PionixPublic/cb-eval-board/cb-eval-board/adcs.kicad_sch

## KiCad design cb-eval-board/adcs.kicad_sch (2025-07-17)

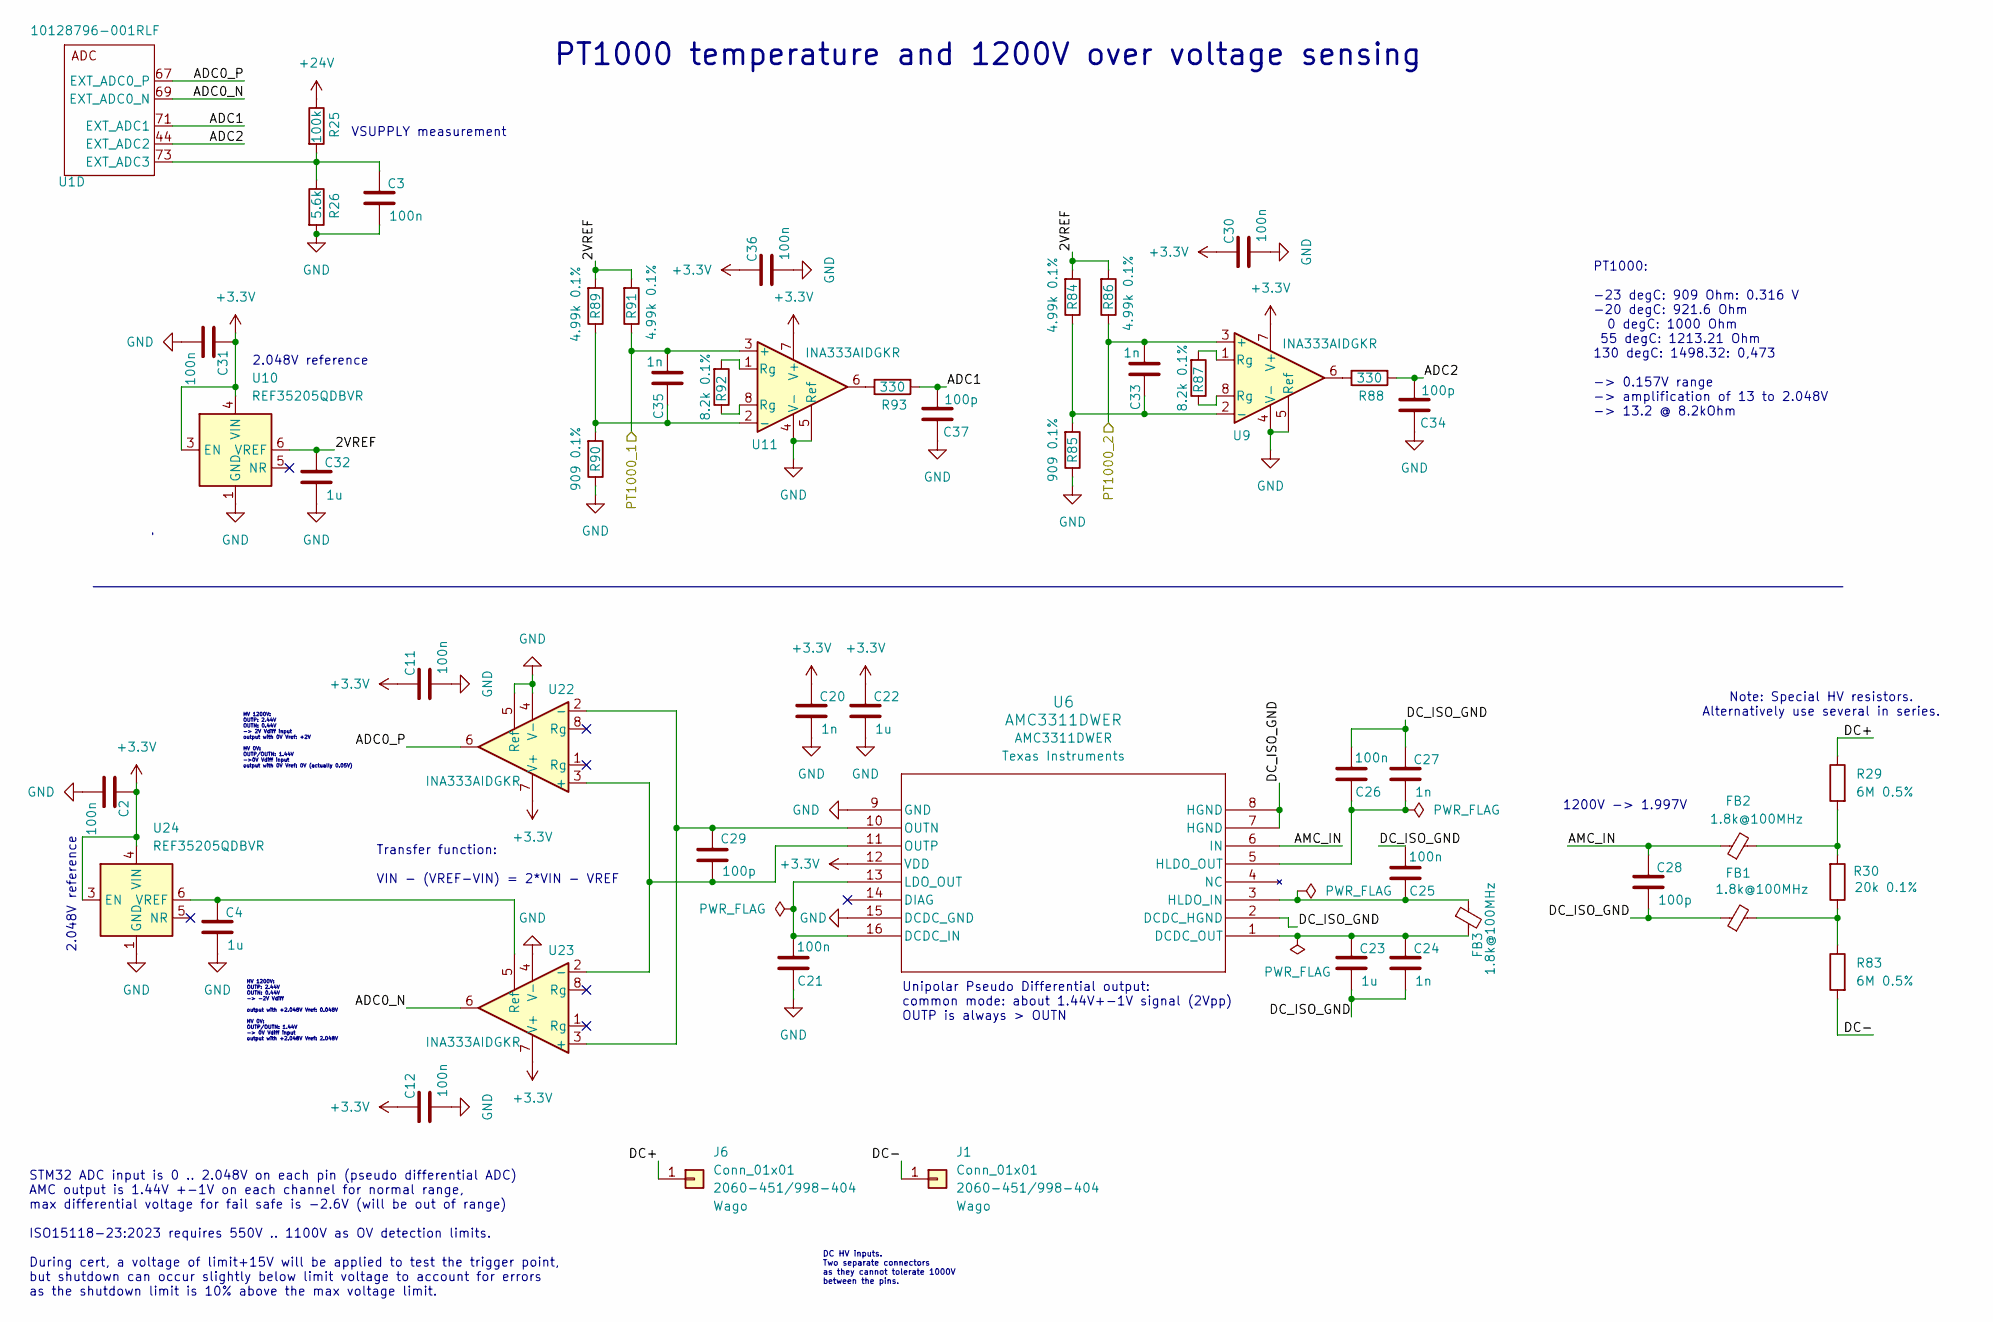
[picture p1: schematic adcs.kicad_sch]

Parts:
C2, C3, C11, C12, C21, C25, C26, C30, C31, C36: 100n; C_0603_1608Metric; MPN C0603C104K5RACAUTO; Digikey 399-6856-1-ND
C4, C22, C23, C32: 1u; C_0603_1608Metric; MPN C0603C105K3PACTU; Digikey 399-C0603C105K3PACTUCT-ND
C20, C24, C27, C33, C35: 1n; C_0603_1608Metric; MPN C0603C102K5RACTU; Digikey 399-C0603C102K5RACTUCT-ND
C28, C29, C34, C37: 100p; C_0603_1608Metric; MPN 0603N101J500CT; Digikey 1292-1644-1-ND
FB1, FB2, FB3: 1.8k@100MHz; L_0603_1608Metric; MPN 742792692; Digikey 732-4671-1-ND
J1, J6: Conn_01x01; 2060451998404; MPN 2060-451/998-404; Digikey 2946-2060-451/998-404CT-ND
R25: 100k; R_0603_1608Metric; MPN RMCF0603FT100K; Digikey RMCF0603FT100KCT-ND
R26: 5.6k; R_0603_1608Metric; MPN RMCF0603FT5K60; Digikey RMCF0603FT5K60CT-ND
R29, R83: 6M 0.5%; R_1206_3216Metric; MPN CRMA1206AF6M00DKEF; JLCPCB Part# C3986300
R30: 20k 0.1%; R_0603_1608Metric; MPN ERA-3AEB203V; JLCPCB Part# C469660
R84, R86, R89, R91: 4.99k 0.1%; R_0603_1608Metric; MPN ERA-3AEB4991V; Digikey P4.99KDBCT-ND
R85, R90: 909 0.1%; R_0603_1608Metric; MPN ERA-3AEB9090V; Digikey P909DBCT-ND
R87, R92: 8.2k 0.1%; R_0603_1608Metric; MPN ERA-3AEB822V; Digikey P8.2KDBCT-ND
R88, R93: 330; R_0603_1608Metric; MPN RMCF0603FT330R; Digikey RMCF0603FT330RCT-ND
U1: 10128796-001RLF; AMPHENOL_10128796-001RLF_ChargeBridge_Wurth_standoff; MPN 10128796-001RLF
U6: AMC3311DWER; SOIC16_7P5X10P3_TEX; MPN AMC3311DWER; Digikey 296-AMC3311DWERCT-ND
U9, U11, U22, U23: INA333AIDGKR; VSSOP-8_3x3mm_P0.65mm; MPN INA333AIDGKR; Digikey 296-23564-1-ND
U10, U24: REF35205QDBVR; SOT-23-6; MPN REF35205QDBVR; Digikey 296-REF35205QDBVRCT-ND

Connections:
2VREF: C32.1, R84.2, R86.2, R89.2, R91.2, U10.6 (VREF)
+3.3V: C2.1, C11.1, C12.1, C20.1, C22.1, C30.1, C31.1, C36.1, U6.12 (VDD), U9.7 (V+), U10.3 (EN), U10.4 (VIN), U11.7 (V+), U22.7 (V+), U23.7 (V+), U24.3 (EN), U24.4 (VIN)
+24V: R25.1
ADC0_N: U1.69 (EXT_ADC0_N), U23.6
ADC0_P: U1.67 (EXT_ADC0_P), U22.6
ADC1: C37.2, R93.2, U1.71 (EXT_ADC1)
ADC2: C34.2, R88.2, U1.44 (EXT_ADC2)
AMC_IN: C28.1, FB2.1, U6.6 (IN)
DC+: J6.1, R29.1
DC-: J1.1, R83.2
DC_ISO_GND: C23.2, C24.2, C25.2, C26.2, C27.1, C28.2, FB1.1, U6.2 (DCDC_HGND), U6.7 (HGND), U6.8 (HGND)
GND: C2.2, C3.2, C4.2, C11.2, C12.2, C20.2, C21.1, C22.2, C30.2, C31.2, C32.2, C34.1, C36.2, C37.1, R26.2, R85.1, R90.1, U6.9 (GND), U6.15 (DCDC_GND), U9.4 (V-), U9.5 (Ref), U10.1 (GND), U10.2 (GND), U11.4 (V-), U11.5 (Ref), U22.4 (V-), U22.5 (Ref), U23.4 (V-), U24.1 (GND), U24.2 (GND)
unnamed: C3.1, R25.2, R26.1, U1.73 (EXT_ADC3)
unnamed: C4.1, U23.5 (Ref), U24.6 (VREF)
unnamed: C21.2, U6.13 (LDO_OUT), U6.16 (DCDC_IN)
unnamed: C23.1, C24.1, FB3.2, U6.1 (DCDC_OUT)
unnamed: C25.1, FB3.1, U6.3 (HLDO_IN)
unnamed: C26.1, C27.2, U6.5 (HLDO_OUT)
unnamed: C29.1, U6.10 (OUTN), U22.2 (-), U23.3 (+)
unnamed: C29.2, U6.11 (OUTP), U22.3 (+), U23.2 (-)
unnamed: C33.1, R84.1, R85.2, U9.2 (-)
unnamed: C35.1, R89.1, R90.2, U11.2 (-)
unnamed: FB1.2, R30.1, R83.1
unnamed: FB2.2, R29.2, R30.2
unnamed: R87.1, U9.8 (Rg)
unnamed: R87.2, U9.1 (Rg)
unnamed: R88.1, U9.6
unnamed: R92.1, U11.8 (Rg)
unnamed: R92.2, U11.1 (Rg)
unnamed: R93.1, U11.6
PT1000_1: C35.2, R91.1, U11.3 (+)
PT1000_2: C33.2, R86.1, U9.3 (+)

Notes on the sheet:
HV 1200V: OUTP: 2.44V OUTN: 0.44V -> 2V Vdiff input output with 0V Vref: +2V HV 0V: OUTP/OUTN: 1.44V ->0V Vdiff input output with 0V Vref: 0V (actually 0.05V)
STM32 ADC input is 0 .. 2.048V on each pin (pseudo differential ADC) AMC output is 1.44V +-1V on each channel for normal range, max differential voltage for fail safe is -2.6V (will be out of range) ISO15118-23:2023 requires 550V .. 1100V as OV detection limits. During cert, a voltage of limit+15V 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
2.048V reference
Transfer function: VIN - (VREF-VIN) = 2*VIN - VREF
DC HV inputs. Two separate connectors as they cannot tolerate 1000V between the pins.
1200V -> 1.997V
HV 1200V: OUTP: 2.44V OUTN: 0.44V -> -2V Vdiff output with +2.048V Vref: 0.048V HV 0V: OUTP/OUTN: 1.44V -> 0V Vdiff input output with +2.048V Vref: 2.048V
Note: Special HV resistors. Alternatively use several in series.
VSUPPLY measurement
PT1000 temperature and 1200V over voltage sensing
PT1000: -23 degC: 909 Ohm: 0.316 V -20 degC: 921.6 Ohm 0 degC: 1000 Ohm 55 degC: 1213.21 Ohm 130 degC: 1498.32: 0,473 -> 0.157V range -> amplification of 13 to 2.048V -> 13.2 @ 8.2kOhm
Unipolar Pseudo Differential output: common mode: about 1.44V+-1V signal (2Vpp) OUTP is always > OUTN
