PionixPublic/cb-eval-board/cb-eval-board/cb-eval-board.kicad_sch

## KiCad design cb-eval-board/cb-eval-board.kicad_sch (2025-07-17)

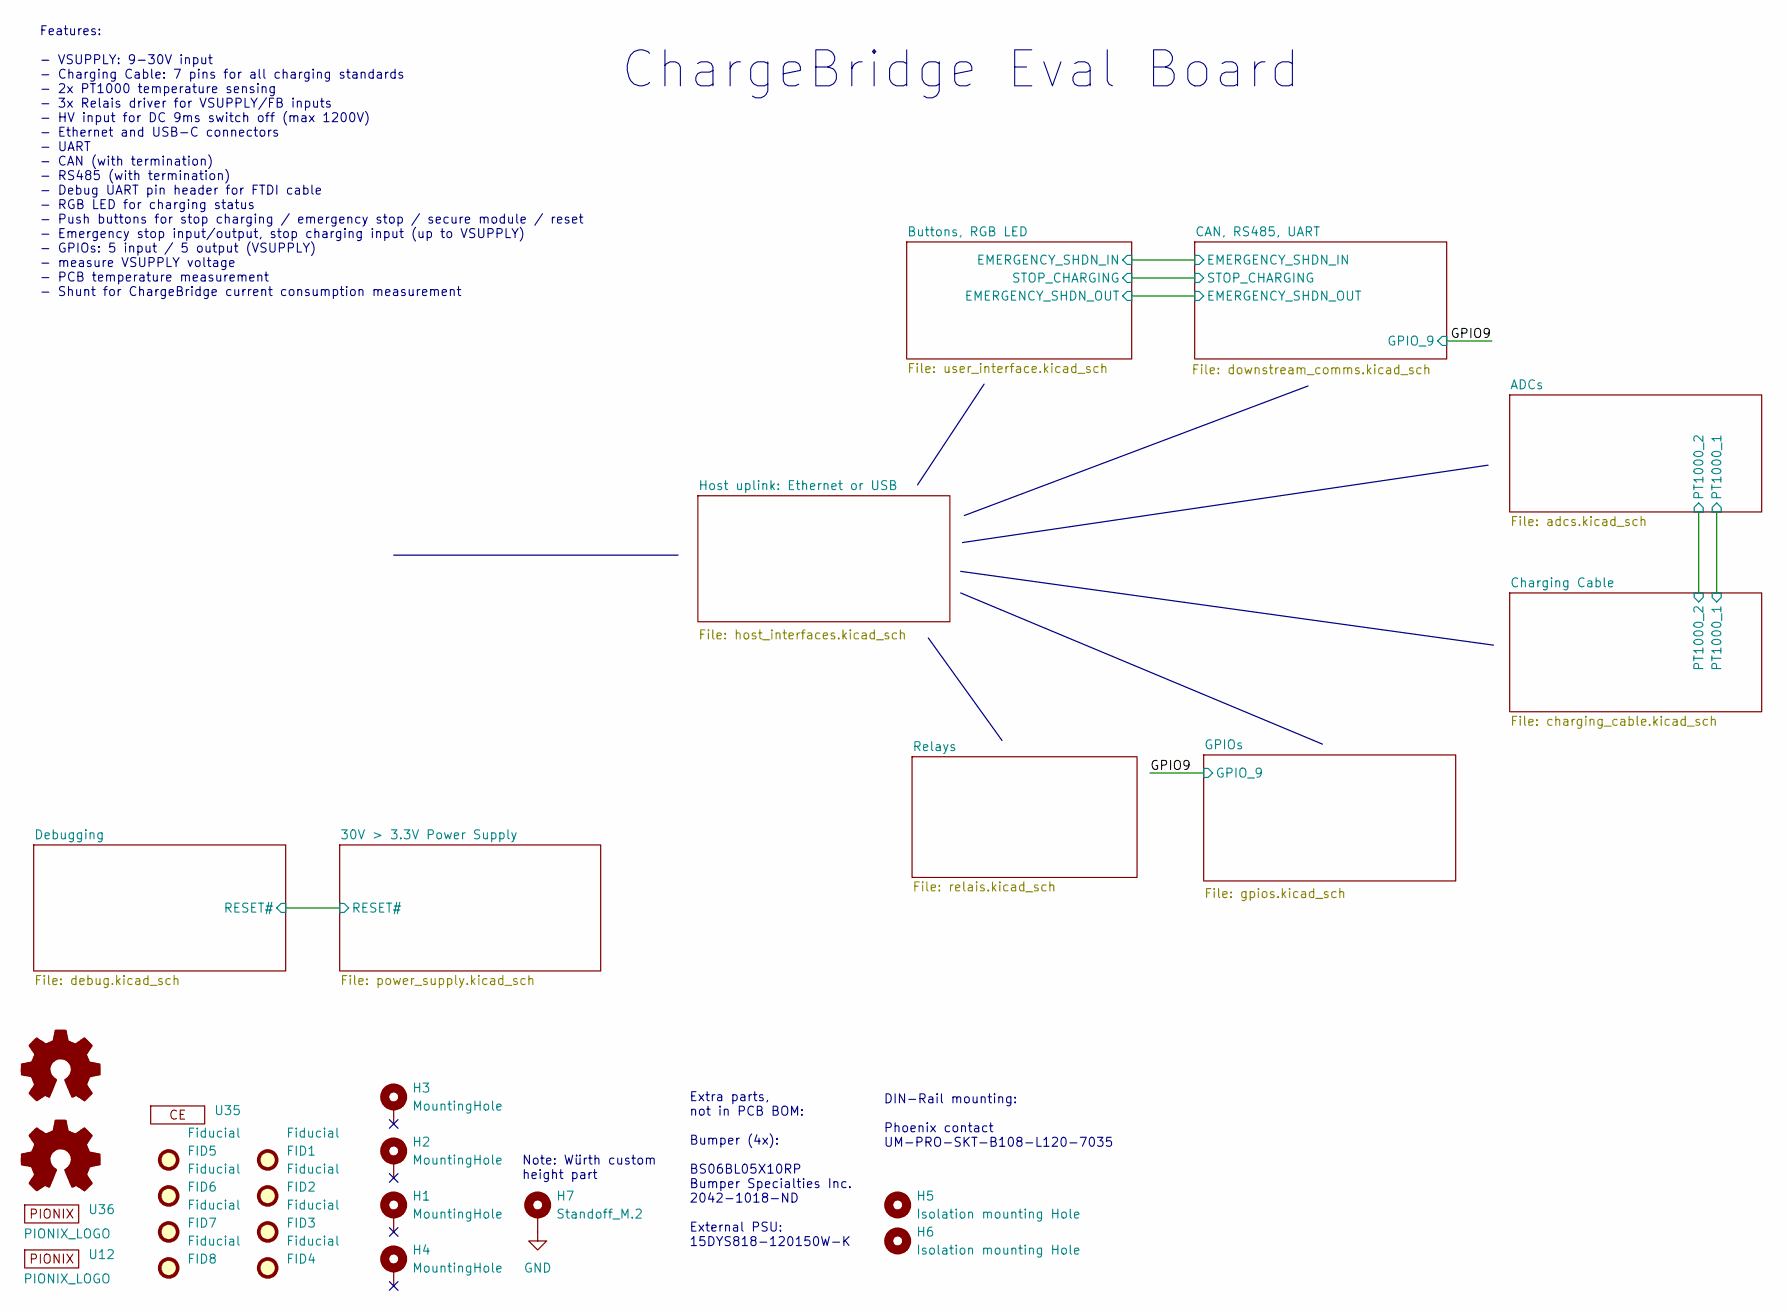
[picture p2: schematic cb-eval-board.kicad_sch]

Parts:
FID1, FID2, FID3, FID4, FID5, FID6, FID7, FID8: Fiducial; Fiducial_0.5mm_Mask1.5mm; MPN DNP
H1, H2, H3, H4: MountingHole; MountingHole_2.2mm_M2_DIN965_Pad; MPN DNP
H5, H6: Isolation mounting Hole; MountingHole_2.7mm_M2.5_ISO14580; MPN DNP
H7: Standoff_M.2; 9774067243R; MPN 9774067243R
SYM1: Logo_Open_Hardware_Small; Symbol_Barrel_Polarity
SYM2: Logo_Open_Hardware_Small; OSHW-Symbol_6.7x6mm_SilkScreen
U12: PIONIX_LOGO; pionix-logo-2_5mm-new; MPN LOGO
U35: CE-Logo_8.5x6mm_SilkScreen
U36: PIONIX_LOGO; pionix-logo-mark; MPN LOGO

Connections:
GND: H7.1

Notes on the sheet:
Note: Würth custom height part
ChargeBridge Eval Board
DIN-Rail mounting: Phoenix contact UM-PRO-SKT-B108-L120-7035
Extra parts, not in PCB BOM: Bumper (4x): BS06BL05X10RP Bumper Specialties Inc. 2042-1018-ND External PSU: 15DYS818-120150W-K
Features: - VSUPPLY: 9-30V input - Charging Cable: 7 pins for all charging standards - 2x PT1000 temperature sensing - 3x Relais driver for VSUPPLY/FB inputs - HV input for DC 9ms switch off (max 1200V) - Ethernet and USB-C connectors - UART - CAN (with termination) - RS485 (with termination) - Deb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
