PionixPublic/cb-eval-board/cb-eval-board/charging_cable.kicad_sch

## KiCad design cb-eval-board/charging_cable.kicad_sch (2025-07-17)

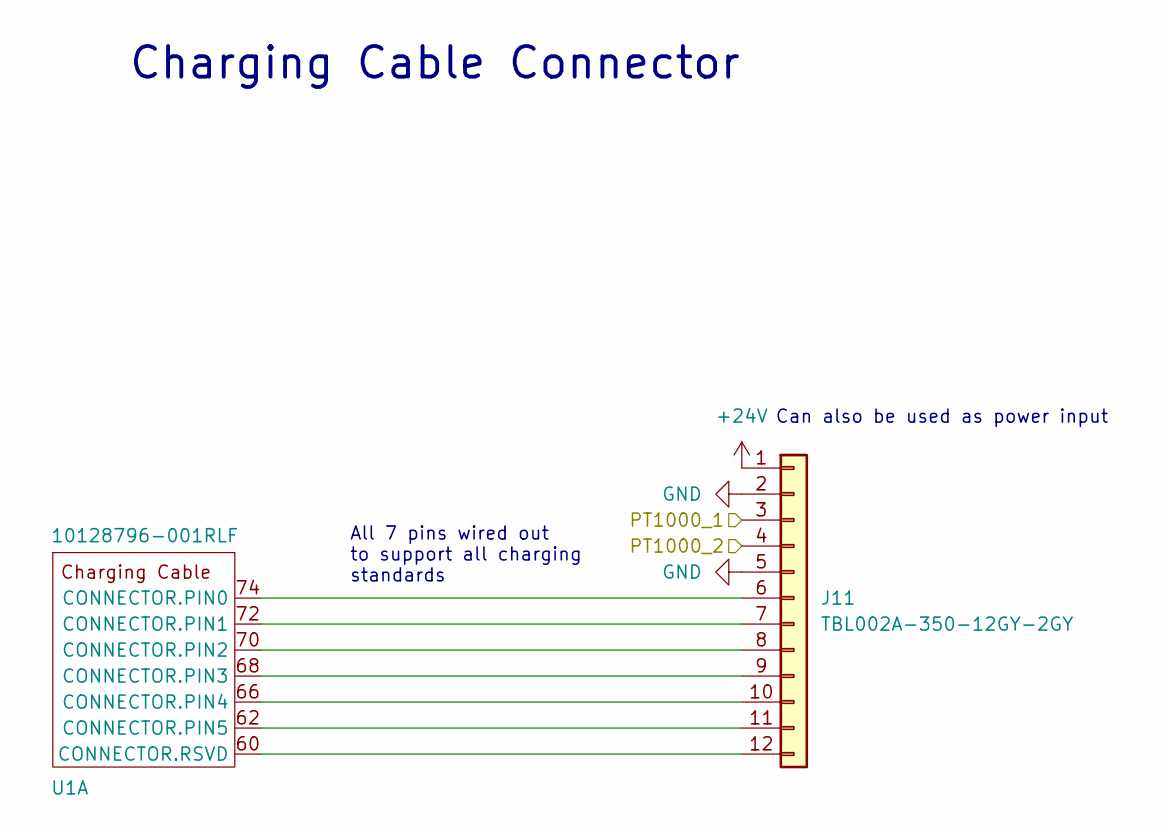
[picture p3: schematic charging_cable.kicad_sch]

Parts:
J11: TBL002A-350-12GY-2GY; CUI_TBL002A-350-12GY-2GY; MPN TBL002A-350-12GY-2GY; Digikey 102-6375-ND
U1: 10128796-001RLF; AMPHENOL_10128796-001RLF_ChargeBridge_Wurth_standoff; MPN 10128796-001RLF

Connections:
+24V: J11.1
GND: J11.2, J11.5
unnamed: J11.6, U1.74 (CONNECTOR.PIN0)
unnamed: J11.7, U1.72 (CONNECTOR.PIN1)
unnamed: J11.8, U1.70 (CONNECTOR.PIN2)
unnamed: J11.9, U1.68 (CONNECTOR.PIN3)
unnamed: J11.10, U1.66 (CONNECTOR.PIN4)
unnamed: J11.11, U1.62 (CONNECTOR.PIN5)
unnamed: J11.12, U1.60 (CONNECTOR.RSVD)
PT1000_1: J11.3
PT1000_2: J11.4

Notes on the sheet:
Charging Cable Connector
Can also be used as power input
All 7 pins wired out to support all charging standards
