PionixPublic/cb-eval-board/cb-eval-board/debug.kicad_sch

## KiCad design cb-eval-board/debug.kicad_sch (2025-07-17)

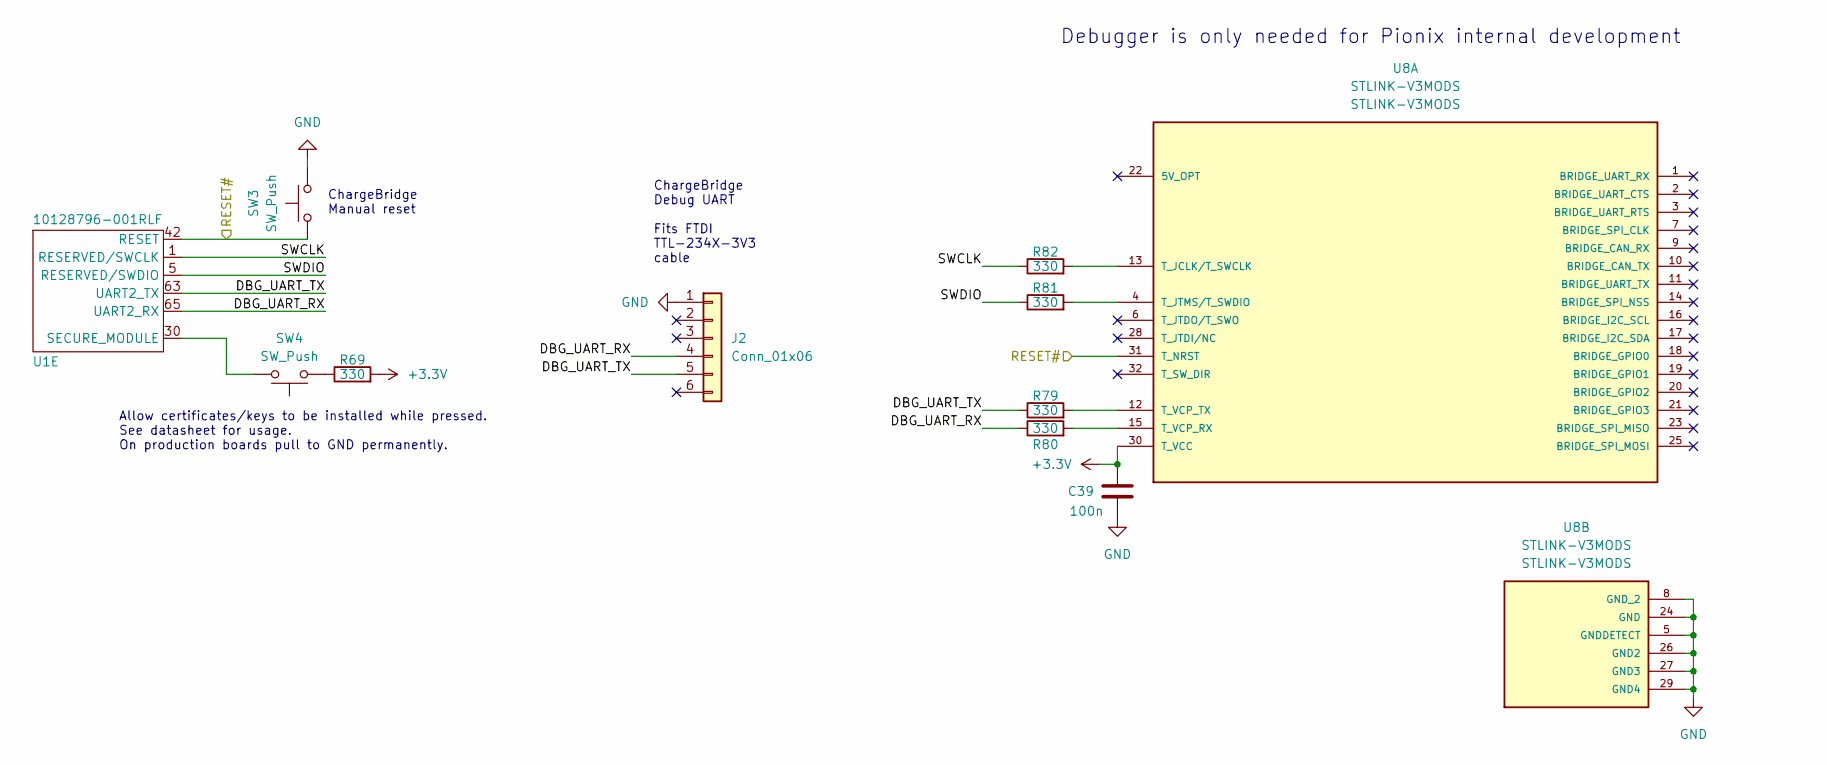
[picture p4: schematic debug.kicad_sch]

Parts:
C39: 100n; C_0603_1608Metric; MPN C0603C104K5RACAUTO; Digikey 399-6856-1-ND
J2: Conn_01x06; PinHeader_1x06_P2.54mm_Vertical; MPN TS-106-T-A; Digikey SAM1112-06-ND
R69, R79, R80, R81, R82: 330; R_0603_1608Metric; MPN RMCF0603FT330R; Digikey RMCF0603FT330RCT-ND
SW3, SW4: SW_Push; SW_TS02-66-70-BK-160-LCR-D; MPN TS02-66-70-BK-160-LCR-D; Digikey 2223-TS02-66-70-BK-160-LCR-D-ND
U1: 10128796-001RLF; AMPHENOL_10128796-001RLF_ChargeBridge_Wurth_standoff; MPN 10128796-001RLF
U8: STLINK-V3MODS; MODULE_STLINK-V3MODS; PARTREV 1; Digikey 497-STLINK-V3MODS-ND

Connections:
+3.3V: C39.1, R69.2, U8.30 (T_VCC)
DBG_UART_RX: J2.4, R80.1, U1.65 (UART2_RX)
DBG_UART_TX: J2.5, R79.1, U1.63 (UART2_TX)
GND: C39.2, J2.1, SW3.2, U8.5 (GNDDETECT), U8.8 (GND_2), U8.24 (GND), U8.26 (GND2), U8.27 (GND3), U8.29 (GND4)
unnamed: R69.1, SW4.1
unnamed: R79.2, U8.12 (T_VCP_TX)
unnamed: R80.2, U8.15 (T_VCP_RX)
unnamed: R81.2, U8.4 (T_JTMS/T_SWDIO)
unnamed: R82.2, U8.13 (T_JCLK/T_SWCLK)
unnamed: SW4.2, U1.30 (SECURE_MODULE)
RESET#: SW3.1, U1.42 (RESET), U8.31 (T_NRST)
SWCLK: R82.1, U1.1 (RESERVED/SWCLK)
SWDIO: R81.1, U1.5 (RESERVED/SWDIO)

Notes on the sheet:
Allow certificates/keys to be installed while pressed. See datasheet for usage. On production boards pull to GND permanently.
Debugger is only needed for Pionix internal development
ChargeBridge Manual reset
ChargeBridge Debug UART Fits FTDI TTL-234X-3V3 cable
