PionixPublic/cb-eval-board/cb-eval-board/downstream_comms.kicad_sch

## KiCad design cb-eval-board/downstream_comms.kicad_sch (2025-07-17)

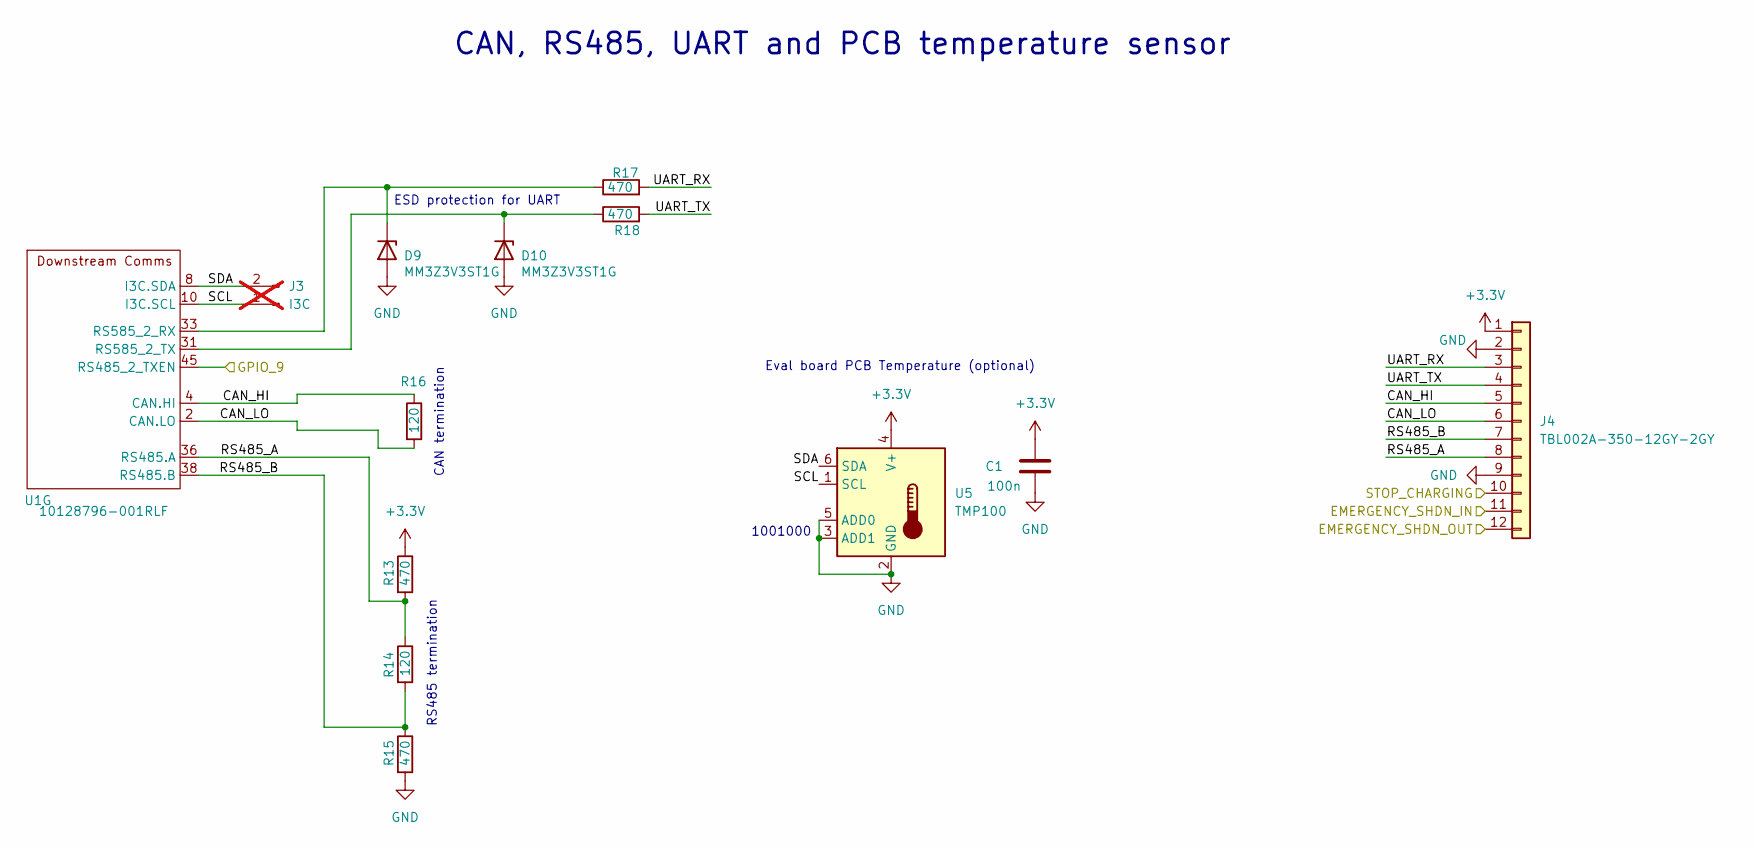
[picture p5: schematic downstream_comms.kicad_sch]

Parts:
C1: 100n; C_0603_1608Metric; MPN C0603C104K5RACAUTO; Digikey 399-6856-1-ND
D9, D10: MM3Z3V3ST1G; D_SOD-323; MPN MM3Z3V3ST1G; Digikey MM3Z3V3ST1GOSCT-ND
J3: I3C; PinHeader_1x02_P2.54mm_Vertical; MPN DNP; not fitted
J4: TBL002A-350-12GY-2GY; CUI_TBL002A-350-12GY-2GY; MPN TBL002A-350-12GY-2GY; Digikey 102-6375-ND
R13, R15, R17, R18: 470; R_0603_1608Metric; MPN RMCF0603FT470R; Digikey RMCF0603FT470RCT-ND
R14, R16: 120; R_0603_1608Metric; MPN RMCF0603FT120R; Digikey RMCF0603FT120RCT-ND
U1: 10128796-001RLF; AMPHENOL_10128796-001RLF_ChargeBridge_Wurth_standoff; MPN 10128796-001RLF
U5: TMP100; SOT-23-6; MPN TMP100NA/3K; Digikey 296-26833-1-ND

Connections:
+3.3V: C1.1, J4.1, R13.1, U5.4 (V+)
CAN_HI: J4.5, R16.1, U1.4 (CAN.HI)
CAN_LO: J4.6, R16.2, U1.2 (CAN.LO)
EMERGENCY_SHDN_IN: J4.11
EMERGENCY_SHDN_OUT: J4.12
GND: C1.2, D9.2 (A), D10.2 (A), J4.2, J4.9, R15.2, U5.2 (GND), U5.3 (ADD1), U5.5 (ADD0)
GPIO_9: U1.45 (RS485_2_TXEN)
unnamed: D9.1 (K), R17.1, U1.33 (RS585_2_RX)
unnamed: D10.1 (K), R18.1, U1.31 (RS585_2_TX)
RS485_A: J4.8, R13.2, R14.1, U1.36 (RS485.A)
RS485_B: J4.7, R14.2, R15.1, U1.38 (RS485.B)
SCL: J3.1, U1.10 (I3C.SCL), U5.1 (SCL)
SDA: J3.2, U1.8 (I3C.SDA), U5.6 (SDA)
STOP_CHARGING: J4.10
UART_RX: J4.3, R17.2
UART_TX: J4.4, R18.2

Notes on the sheet:
Eval board PCB Temperature (optional)
1001000
ESD protection for UART
CAN termination
RS485 termination
CAN, RS485, UART and PCB temperature sensor
