PionixPublic/cb-eval-board/cb-eval-board/gpios.kicad_sch

## KiCad design cb-eval-board/gpios.kicad_sch (2025-07-17)

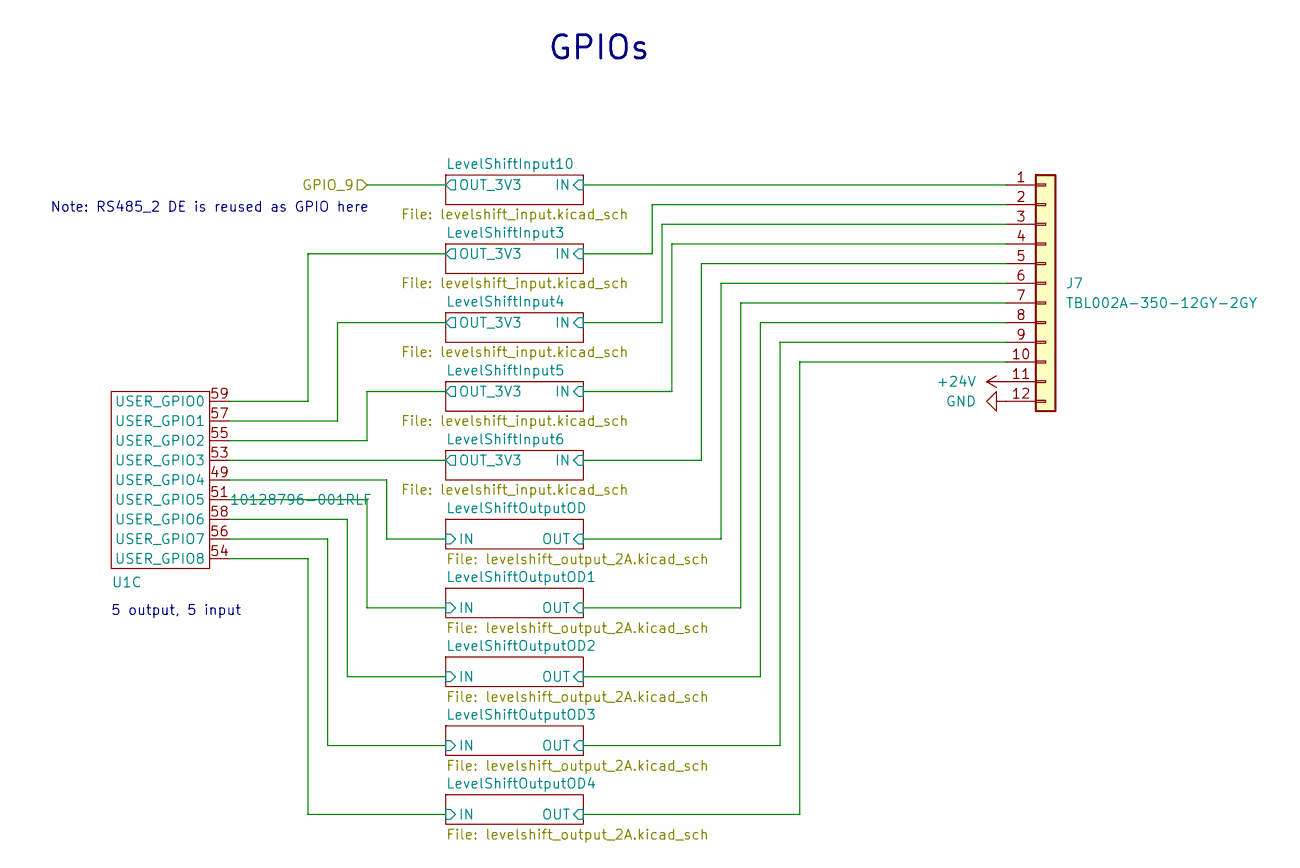
[picture p6: schematic gpios.kicad_sch]

Parts:
J7: TBL002A-350-12GY-2GY; CUI_TBL002A-350-12GY-2GY; MPN TBL002A-350-12GY-2GY; Digikey 102-6375-ND
U1: 10128796-001RLF; AMPHENOL_10128796-001RLF_ChargeBridge_Wurth_standoff; MPN 10128796-001RLF

Connections:
+24V: J7.11
GND: J7.12
IN: J7.1, J7.2, J7.3, J7.4, J7.5, U1.49 (USER_GPIO4), U1.51 (USER_GPIO5), U1.54 (USER_GPIO8), U1.56 (USER_GPIO7), U1.58 (USER_GPIO6)
OUT: J7.6, J7.7, J7.8, J7.9, J7.10
OUT_3V3: U1.53 (USER_GPIO3), U1.55 (USER_GPIO2), U1.57 (USER_GPIO1), U1.59 (USER_GPIO0)

Notes on the sheet:
5 output, 5 input
GPIOs
Note: RS485_2 DE is reused as GPIO here
