PionixPublic/cb-eval-board/cb-eval-board/host_interfaces.kicad_sch

## KiCad design cb-eval-board/host_interfaces.kicad_sch (2025-07-17)

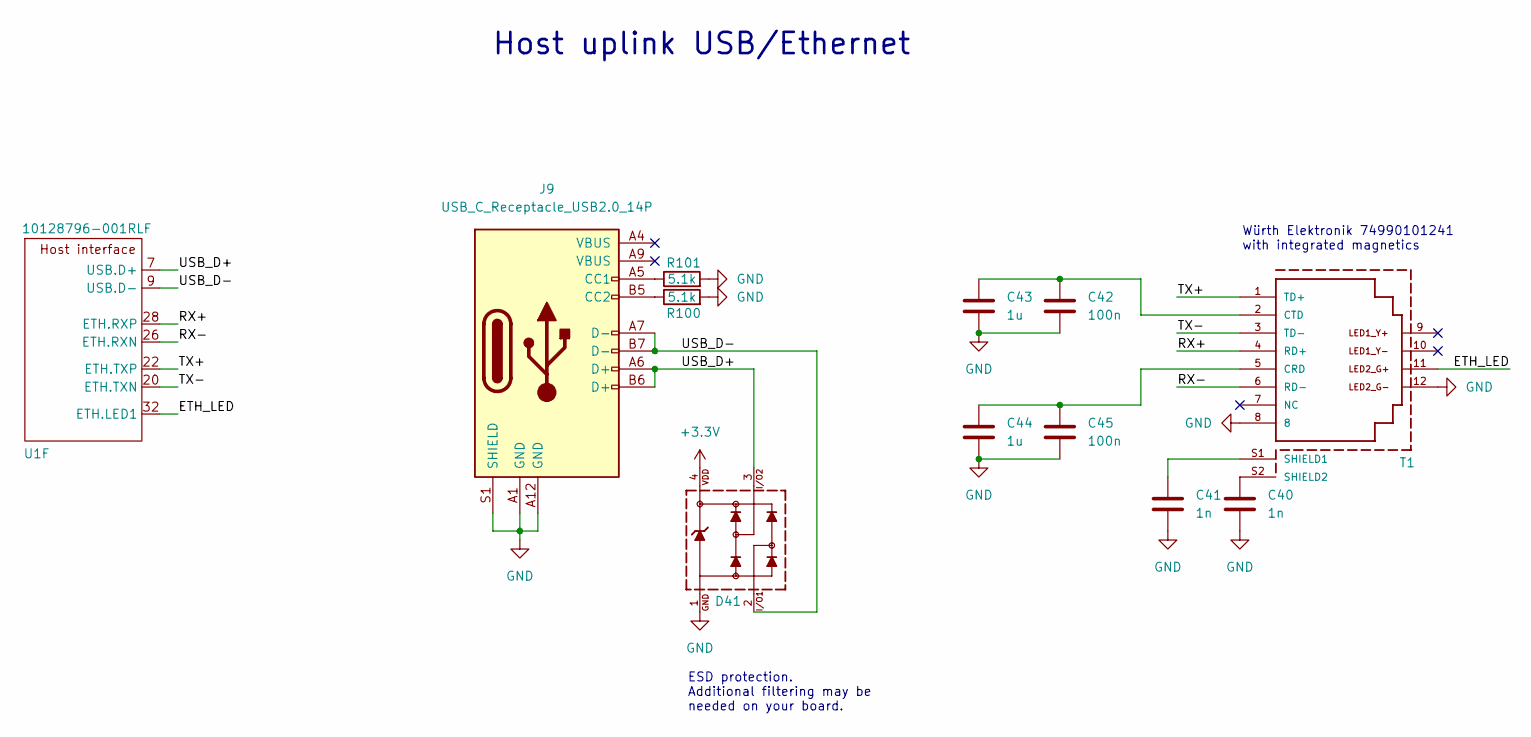
[picture p7: schematic host_interfaces.kicad_sch]

Parts:
C40, C41: 1n; C_0603_1608Metric; MPN C0603C102K5RACTU; Digikey 399-C0603C102K5RACTUCT-ND
C42, C45: 100n; C_0603_1608Metric; MPN C0603C104K5RACAUTO; Digikey 399-6856-1-ND
C43, C44: 1u; C_0603_1608Metric; MPN C0603C105K3PACTU; Digikey 399-C0603C105K3PACTUCT-ND
D41: 5Vdc; WE-TVS_SOT143-4L; MPN STS142050UL08; Digikey 283-STS142050UL08CT-ND
J9: USB_C_Receptacle_USB2.0_14P; USB_C_Receptacle_GCT_USB4110; MPN USB4110-GF-A; Digikey 2073-USB4110-GF-A-1-ND
R100, R101: 5.1k; R_0603_1608Metric; MPN RMCF0603FT5K10; Digikey RMCF0603FT5K10CT-ND
T1: 74990101241; MPN 74990101241; Digikey 732-10834-ND
U1: 10128796-001RLF; AMPHENOL_10128796-001RLF_ChargeBridge_Wurth_standoff; MPN 10128796-001RLF

Connections:
+3.3V: D41.4
ETH_LED: T1.11, U1.32 (ETH.LED1)
GND: C40.2, C41.2, C42.2, C43.2, C44.2, C45.2, D41.1, J9.A1 (GND), J9.A12 (GND), J9.S1 (SHIELD), R100.2, R101.2, T1.8, T1.12
unnamed: C40.1, T1.S2 (SHIELD2)
unnamed: C41.1, T1.S1 (SHIELD1)
unnamed: C42.1, C43.1, T1.2 (CTD)
unnamed: C44.1, C45.1, T1.5 (CRD)
unnamed: J9.A5 (CC1), R101.1
unnamed: J9.B5 (CC2), R100.1
RX+: T1.4 (RD+), U1.28 (ETH.RXP)
RX-: T1.6 (RD-), U1.26 (ETH.RXN)
TX+: T1.1 (TD+), U1.22 (ETH.TXP)
TX-: T1.3 (TD-), U1.20 (ETH.TXN)
USB_D+: D41.3, J9.A6 (D+), J9.B6 (D+), U1.7 (USB.D+)
USB_D-: D41.2, J9.A7 (D-), J9.B7 (D-), U1.9 (USB.D-)

Notes on the sheet:
Würth Elektronik 74990101241 with integrated magnetics
Host uplink USB/Ethernet
ESD protection. Additional filtering may be needed on your board.
