PionixPublic/cb-eval-board/cb-eval-board/levelshift_input.kicad_sch

## KiCad design cb-eval-board/levelshift_input.kicad_sch (2025-07-17)

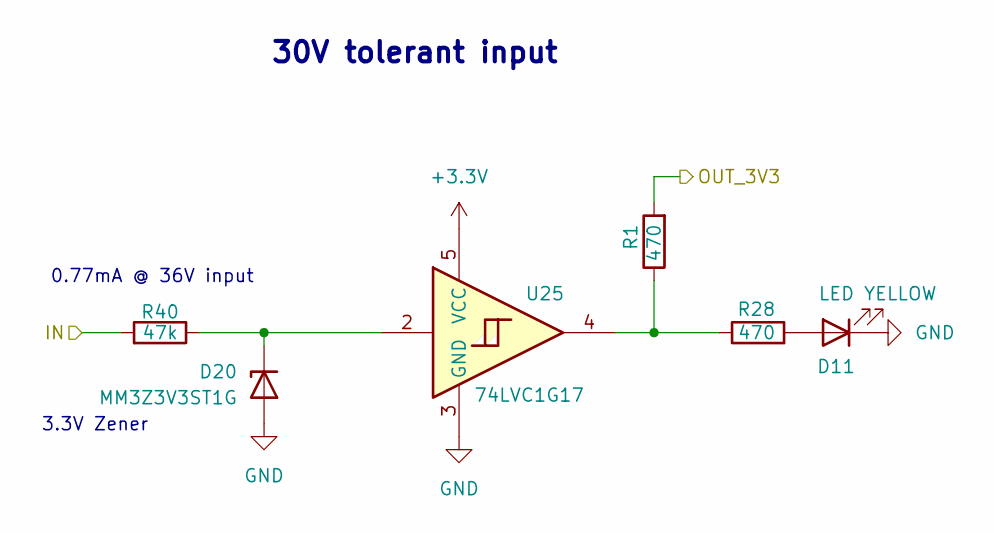
[picture p8: schematic levelshift_input.kicad_sch]

Parts:
D11: LED YELLOW; LED_0603_1608Metric; MPN 150060AS75000; Digikey 732-150060AS75000CT-ND
D20: MM3Z3V3ST1G; D_SOD-323; MPN MM3Z3V3ST1G; Digikey MM3Z3V3ST1GOSCT-ND
R1, R28: 470; R_0603_1608Metric; MPN RMCF0603FT470R; Digikey RMCF0603FT470RCT-ND
R40: 47k; R_0603_1608Metric; MPN RMCF0603FT47K0; Digikey RMCF0603FT47K0CT-ND
U25: 74LVC1G17; SOT-353_SC-70-5; MPN SN74LVC1G17DCKR; Digikey 296-11934-1-ND

Connections:
+3.3V: U25.5 (VCC)
GND: D11.1 (K), D20.2 (A), U25.3 (GND)
IN: R40.2
unnamed: D11.2 (A), R28.2
unnamed: D20.1 (K), R40.1, U25.2
unnamed: R1.1, R28.1, U25.4
OUT_3V3: R1.2

Notes on the sheet:
3.3V Zener
0.77mA @ 36V input
30V tolerant input
