PionixPublic/cb-eval-board/cb-eval-board/levelshift_output_2A.kicad_sch

## KiCad design cb-eval-board/levelshift_output_2A.kicad_sch (2025-07-17)

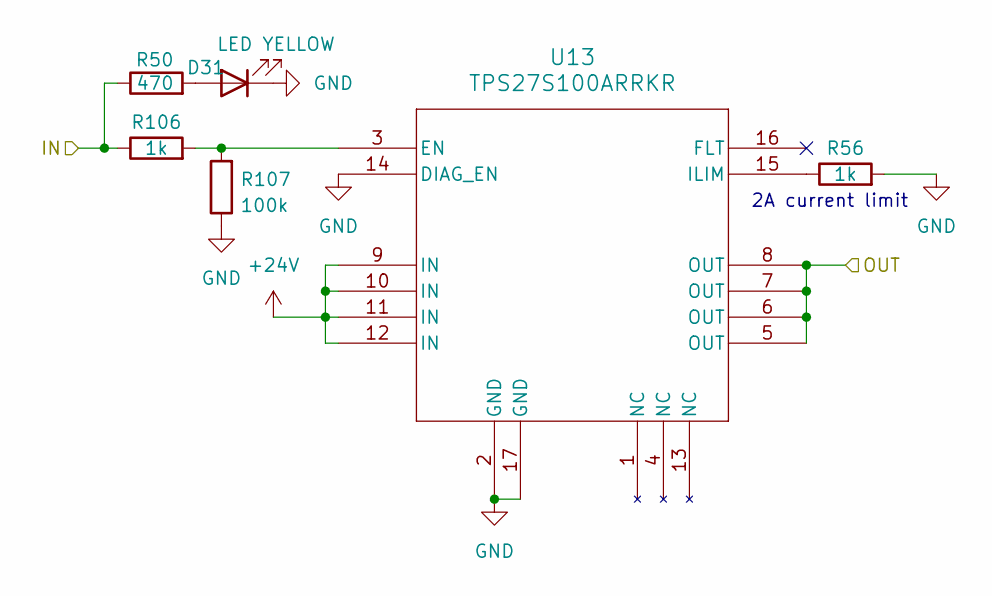
[picture p9: schematic levelshift_output_2A.kicad_sch]

Parts:
D31: LED YELLOW; LED_0603_1608Metric; MPN 150060AS75000; Digikey 732-150060AS75000CT-ND
R50: 470; R_0603_1608Metric; MPN RMCF0603FT470R; Digikey RMCF0603FT470RCT-ND
R56, R106: 1k; R_0603_1608Metric; MPN RMCF0603FG1K00; Digikey RMCF0603FG1K00CT-ND
R107: 100k; R_0603_1608Metric; MPN RMCF0603FT100K; Digikey RMCF0603FT100KCT-ND
U13: TPS27S100ARRKR; WQFN16_RRK_TEX; MPN TPS27S100ARRKR; Digikey 296-TPS27S100ARRKRCT-ND

Connections:
+24V: U13.9 (IN), U13.10 (IN), U13.11 (IN), U13.12 (IN)
GND: D31.1 (K), R56.2, R107.1, U13.2 (GND), U13.14 (DIAG_EN), U13.17 (GND)
IN: R50.1, R106.1
unnamed: D31.2 (A), R50.2
unnamed: R56.1, U13.15 (ILIM)
unnamed: R106.2, R107.2, U13.3 (EN)
OUT: U13.5 (OUT), U13.6 (OUT), U13.7 (OUT), U13.8 (OUT)

Notes on the sheet:
2A current limit
