PionixPublic/cb-eval-board/cb-eval-board/levelshift_output_5A.kicad_sch

## KiCad design cb-eval-board/levelshift_output_5A.kicad_sch (2025-07-17)

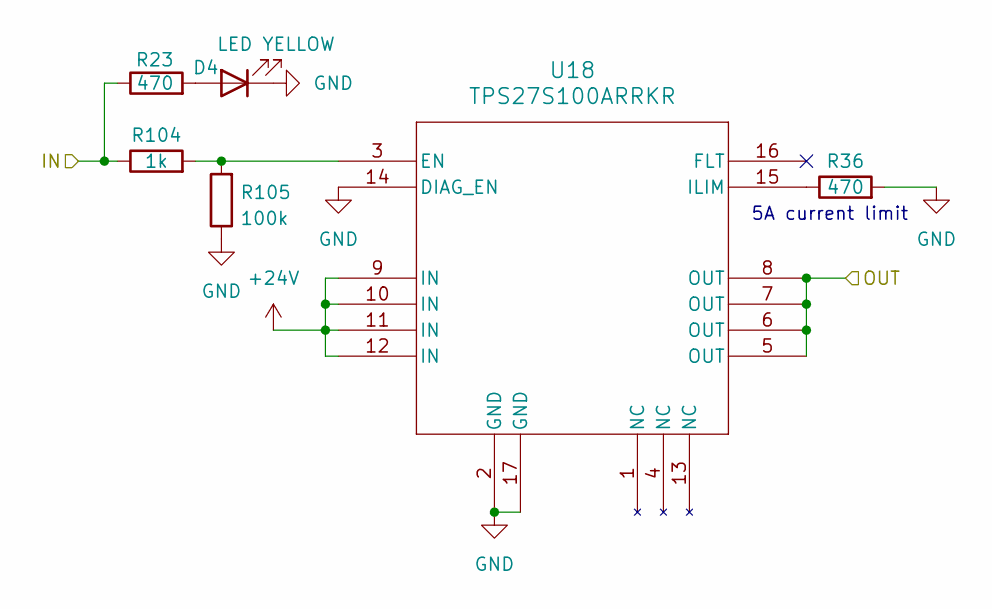
[picture p10: schematic levelshift_output_5A.kicad_sch]

Parts:
D4: LED YELLOW; LED_0603_1608Metric; MPN 150060AS75000; Digikey 732-150060AS75000CT-ND
R23, R36: 470; R_0603_1608Metric; MPN RMCF0603FT470R; Digikey RMCF0603FT470RCT-ND
R104: 1k; R_0603_1608Metric; MPN RMCF0603FG1K00; Digikey RMCF0603FG1K00CT-ND
R105: 100k; R_0603_1608Metric; MPN RMCF0603FT100K; Digikey RMCF0603FT100KCT-ND
U18: TPS27S100ARRKR; WQFN16_RRK_TEX; MPN TPS27S100ARRKR; Digikey 296-TPS27S100ARRKRCT-ND

Connections:
+24V: U18.9 (IN), U18.10 (IN), U18.11 (IN), U18.12 (IN)
GND: D4.1 (K), R36.2, R105.1, U18.2 (GND), U18.14 (DIAG_EN), U18.17 (GND)
IN: R23.1, R104.1
unnamed: D4.2 (A), R23.2
unnamed: R36.1, U18.15 (ILIM)
unnamed: R104.2, R105.2, U18.3 (EN)
OUT: U18.5 (OUT), U18.6 (OUT), U18.7 (OUT), U18.8 (OUT)

Notes on the sheet:
5A current limit
