PionixPublic/cb-eval-board/cb-eval-board/power_supply.kicad_sch

## KiCad design cb-eval-board/power_supply.kicad_sch (2025-07-17)

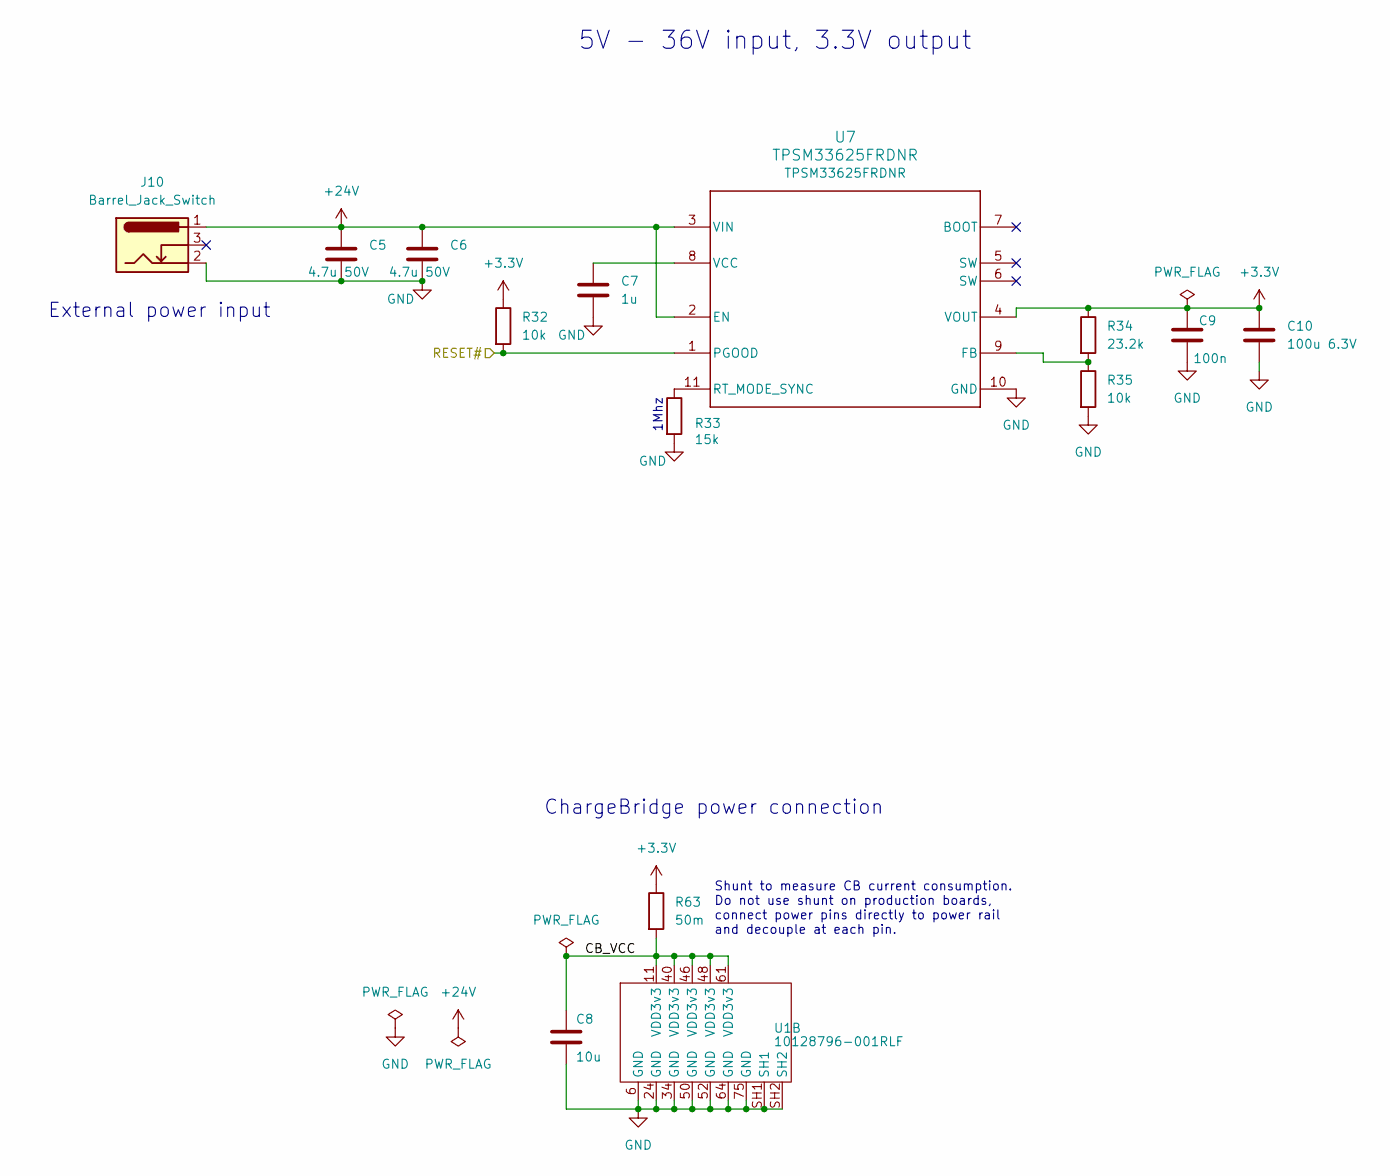
[picture p11: schematic power_supply.kicad_sch]

Parts:
C5, C6: 4.7u 50V; C_1210_3225Metric; MPN C3225X7R1H475K250AB; Digikey 445-7726-1-ND
C7: 1u; C_0603_1608Metric; MPN C0603C105K3PACTU; Digikey 399-C0603C105K3PACTUCT-ND
C8: 10u; C_0603_1608Metric; MPN GRM188R6YA106MA73J; Digikey 490-GRM188R6YA106MA73JCT-ND
C9: 100n; C_0603_1608Metric; MPN C0603C104K5RACAUTO; Digikey 399-6856-1-ND
C10: 100u 6.3V; C_1206_3216Metric; MPN JMK316ABJ107ML-T; Digikey 587-3395-1-ND
J10: Barrel_Jack_Switch; CUI_PJ-044AH; MPN PJ-044AH; Digikey CP-044AH-ND
R32, R35: 10k; R_0603_1608Metric; MPN RMCF0603FT10K0; Digikey RMCF0603FT10K0CT-ND
R33: 15k; R_0603_1608Metric; MPN RMCF0603FT15K0; Digikey RMCF0603FT15K0CT-ND
R34: 23.2k; R_0603_1608Metric; MPN RMCF0603FT23K2; Digikey RMCF0603FT23K2CT-ND
R63: 50m; R_1206_3216Metric; MPN CSR1206FT50L0; Digikey CSR1206FT50L0CT-ND
U1: 10128796-001RLF; AMPHENOL_10128796-001RLF_ChargeBridge_Wurth_standoff; MPN 10128796-001RLF
U7: TPSM33625FRDNR; RDN0011A-MFG; MPN TPSM33625FRDNR; Digikey 296-TPSM33625FRDNRCT-ND

Connections:
+3.3V: C9.1, C10.1, R32.1, R34.1, R63.1, U7.4 (VOUT)
+24V: C5.1, C6.1, J10.1, U7.2 (EN), U7.3 (VIN)
CB_VCC: C8.2, R63.2, U1.11 (VDD3v3), U1.40 (VDD3v3), U1.46 (VDD3v3), U1.48 (VDD3v3), U1.61 (VDD3v3)
GND: C5.2, C6.2, C7.2, C8.1, C9.2, C10.2, J10.2, R33.2, R35.2, U1.6 (GND), U1.24 (GND), U1.34 (GND), U1.50 (GND), U1.52 (GND), U1.64 (GND), U1.75 (GND), U1.SH1, U1.SH2, U7.10 (GND)
unnamed: C7.1, U7.8 (VCC)
unnamed: R33.1, U7.11 (RT_MODE_SYNC)
unnamed: R34.2, R35.1, U7.9 (FB)
RESET#: R32.2, U7.1 (PGOOD)

Notes on the sheet:
5V - 36V input, 3.3V output
Shunt to measure CB current consumption. Do not use shunt on production boards, connect power pins directly to power rail and decouple at each pin.
ChargeBridge power connection
External power input
1Mhz
