PionixPublic/cb-eval-board/cb-eval-board/relais.kicad_sch

## KiCad design cb-eval-board/relais.kicad_sch (2025-07-17)

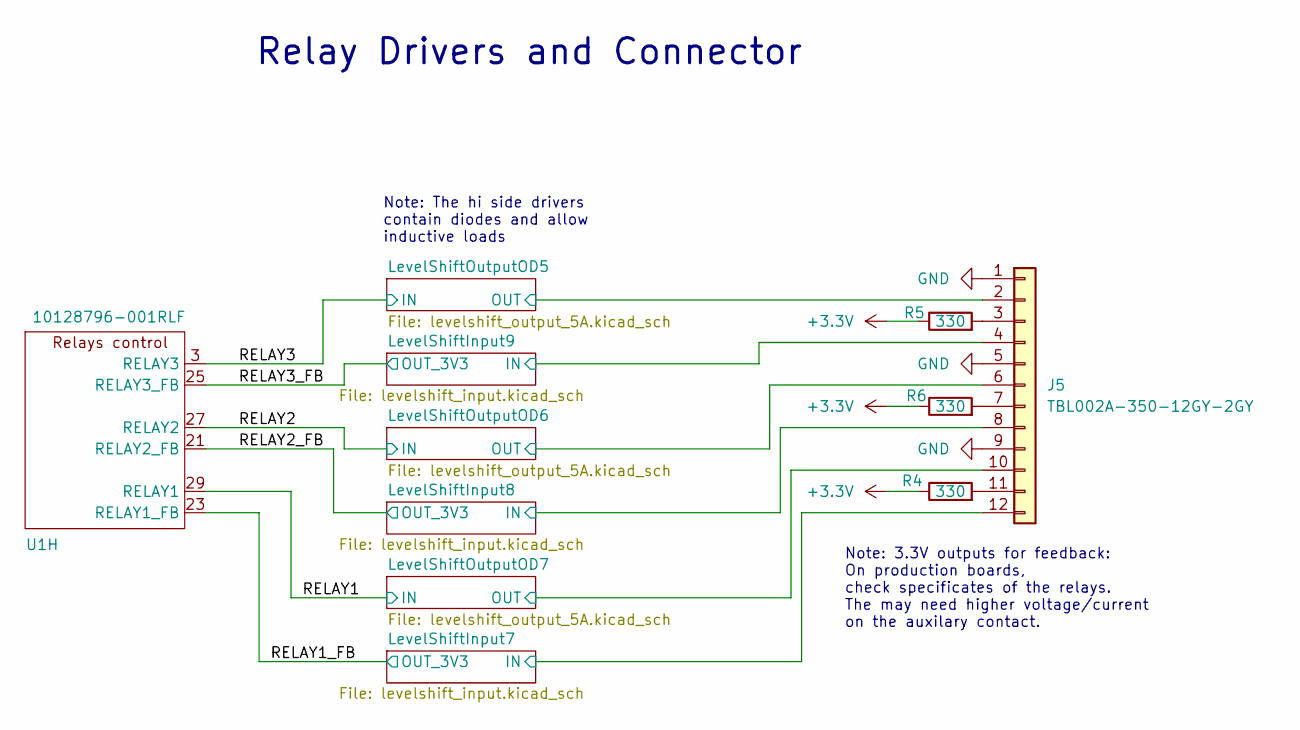
[picture p12: schematic relais.kicad_sch]

Parts:
J5: TBL002A-350-12GY-2GY; CUI_TBL002A-350-12GY-2GY; MPN TBL002A-350-12GY-2GY; Digikey 102-6375-ND
R4, R5, R6: 330; R_0603_1608Metric; MPN RMCF0603FT330R; Digikey RMCF0603FT330RCT-ND
U1: 10128796-001RLF; AMPHENOL_10128796-001RLF_ChargeBridge_Wurth_standoff; MPN 10128796-001RLF

Connections:
+3.3V: R4.1, R5.1, R6.1
GND: J5.1, J5.5, J5.9
IN: J5.4, J5.8, J5.12
unnamed: J5.3, R5.2
unnamed: J5.7, R6.2
unnamed: J5.11, R4.2
OUT: J5.2, J5.6, J5.10
RELAY1: U1.29 (RELAY1)
RELAY1_FB: U1.23 (RELAY1_FB)
RELAY2: U1.27 (RELAY2)
RELAY2_FB: U1.21 (RELAY2_FB)
RELAY3: U1.3 (RELAY3)
RELAY3_FB: U1.25 (RELAY3_FB)

Notes on the sheet:
Relay Drivers and Connector
Note: 3.3V outputs for feedback: On production boards, check specificates of the relays. The may need higher voltage/current on the auxilary contact.
Note: The hi side drivers contain diodes and allow inductive loads
