PionixPublic/cb-eval-board/cb-eval-board/user_interface.kicad_sch

## KiCad design cb-eval-board/user_interface.kicad_sch (2025-07-17)

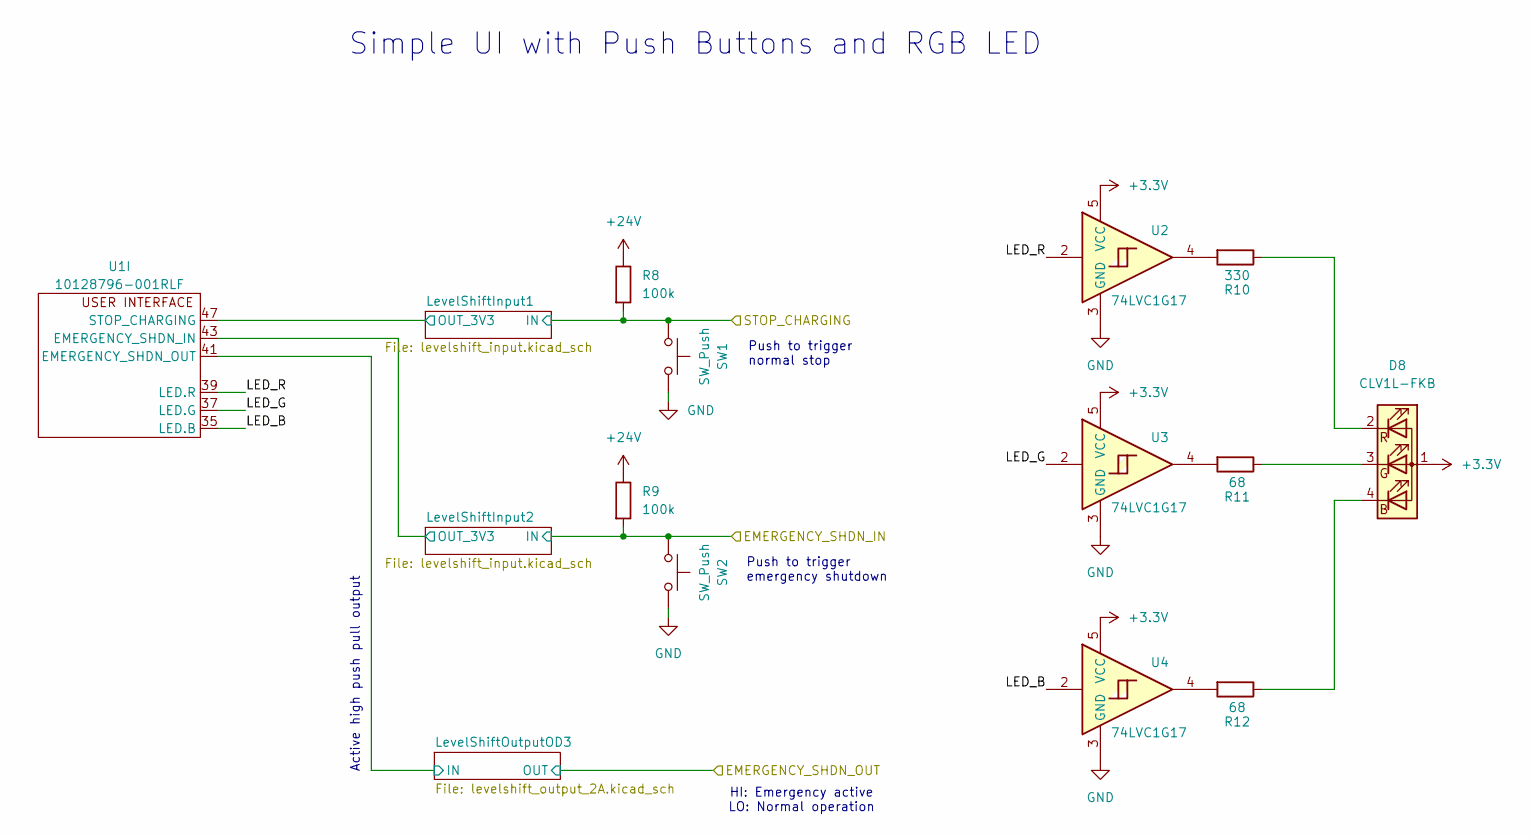
[picture p13: schematic user_interface.kicad_sch]

Parts:
D8: CLV1L-FKB; LED_Cree-PLCC4_3.2x2.8mm_CCW; MPN CLV1L-FKB-CJQRNQEFGBB79353; Digikey 90-CLV1L-FKB-CJQRNQEFGBB79353CT-ND
R8, R9: 100k; R_0603_1608Metric; MPN RMCF0603FT100K; Digikey RMCF0603FT100KCT-ND
R10: 330; R_0603_1608Metric; MPN RMCF0603FT330R; Digikey RMCF0603FT330RCT-ND
R11, R12: 68; R_0603_1608Metric; MPN RMCF0603FT68R0; Digikey RMCF0603FT68R0CT-ND
SW1, SW2: SW_Push; SW_TS02-66-70-BK-160-LCR-D; MPN TS02-66-70-BK-160-LCR-D; Digikey 2223-TS02-66-70-BK-160-LCR-D-ND
U1: 10128796-001RLF; AMPHENOL_10128796-001RLF_ChargeBridge_Wurth_standoff; MPN 10128796-001RLF
U2, U3, U4: 74LVC1G17; SOT-353_SC-70-5; MPN SN74LVC1G17DCKR; Digikey 296-11934-1-ND

Connections:
+3.3V: D8.1 (A), U2.5 (VCC), U3.5 (VCC), U4.5 (VCC)
+24V: R8.1, R9.1
EMERGENCY_SHDN_IN: R9.2, SW2.1
GND: SW1.2, SW2.2, U2.3 (GND), U3.3 (GND), U4.3 (GND)
IN: U1.41 (EMERGENCY_SHDN_OUT)
LED_B: U1.35 (LED.B), U4.2
LED_G: U1.37 (LED.G), U3.2
LED_R: U1.39 (LED.R), U2.2
unnamed: D8.2 (RK), R10.1
unnamed: D8.3 (GK), R11.1
unnamed: D8.4 (BK), R12.1
unnamed: R10.2, U2.4
unnamed: R11.2, U3.4
unnamed: R12.2, U4.4
OUT_3V3: U1.43 (EMERGENCY_SHDN_IN), U1.47 (STOP_CHARGING)
STOP_CHARGING: R8.2, SW1.1

Notes on the sheet:
Active high push pull output
HI: Emergency active LO: Normal operation
Simple UI with Push Buttons and RGB LED
Push to trigger emergency shutdown
Push to trigger normal stop
