PionixPublic/cb-eval-board/(notices)

Notices in the files:
cb-eval-board/charging_cable.kicad_sch:
License: CERN-OHL-P
